eerdemgundogdu/avtech-agv-main/hardware/output/avtech-agv-carrier-revA-bom.csv

Adet | Referanslar | Deger | Footprint | Parca | Not
1 | BZ1 | 5V aktif | Buzzer_12x9.5RM7.6 | 12 mm 5V aktif buzzer
1 | C1 | 47uF 63V | CP_Elec_8x10 | Panasonic EEE-FK1J470P | Toplu giris kondansatoru
2 | C2 C3 | 2.2uF 100V | C_1210_3225Metric | X7R 1210 100V
1 | C4 | 100nF 25V | C_0603_1608Metric | X7R 0603 25V
2 | C5 C6 | 22uF 10V | C_1206_3216Metric | X7R 1206 10V
2 | C7 C8 | 1uF | C_0603_1608Metric | X7R 0603 16V
1 | C9 | 10uF | C_0805_2012Metric | X5R 0805 10V
2 | C10 C11 | 100nF | C_0603_1608Metric | X7R 0603 16V
3 | D1 D3 D10 | SS16 | D_SMA | SS16 (60V 1A) | Bobin serbest gecis diyodu; Buck serbest gecis (catch) diyodu; Ters kutup korumasi
1 | D2 | SMBJ30CA | D_SMB | Littelfuse SMBJ30CA | Vrwm 30V; motor kaynakli sicramalar
1 | D4 | B5819W | D_SOD-123 | B5819W (40V 1A) | USB 5V ile kart 5V birbirini beslemesin
1 | D5 | YESIL | LED_0603_1608Metric | 0603 yesil LED | +5V var
2 | D6 D7 | BAT54S | SOT-23 | BAT54S | RX kiskaci; TX kiskaci
1 | D8 | 1N4148W | D_SOD-323 | 1N4148WS | Buzzer serbest gecis
1 | D9 | MAVI | LED_0603_1608Metric | 0603 mavi LED | Durum (pin 2)
1 | D11 | KIRMIZI | LED_0603_1608Metric | 0603 kirmizi LED | Motor gucu acik
1 | D12 | BZT52C3V3 | D_SOD-123 | BZT52C3V3 | 3.3 V kiskac
1 | F1 | 1A 63V | Fuse_1206_3216Metric | Littelfuse 0466001.NRHF | Lojik + kontaktor bobini
1 | J1 | 24V AKU | TerminalBlock_Phoenix_MKDS-1,5-2-5.08_1x02_P5.08mm_Horizontal | Phoenix 1715721 | Aku girisi (sigortali hattan)
1 | J2 | HOVERBOARD | JST_XH_B3B-XH-A_1x03_P2.50mm_Vertical | JST B3B-XH-A | 15V pini bilerek yok
1 | J3 | IMU SPI | JST_XH_B6B-XH-A_1x06_P2.50mm_Vertical | JST B6B-XH-A
1 | J4 | QTR-8A | JST_XH_B11B-XH-A_1x11_P2.50mm_Vertical | JST B11B-XH-A | Pin 3 = LEDON (hep acik)
1 | J5 | HC-SR04 ON | JST_XH_B4B-XH-A_1x04_P2.50mm_Vertical | JST B4B-XH-A
1 | J6 | HC-SR04 SOL | JST_XH_B4B-XH-A_1x04_P2.50mm_Vertical | JST B4B-XH-A
1 | J7 | HC-SR04 SAG | JST_XH_B4B-XH-A_1x04_P2.50mm_Vertical | JST B4B-XH-A
1 | J8 | DM556 | JST_XH_B6B-XH-A_1x06_P2.50mm_Vertical | JST B6B-XH-A | PUL+ PUL- DIR+ DIR- ENA+ ENA-
1 | J9 | E-STOP (NC) | JST_XH_B2B-XH-A_1x02_P2.50mm_Vertical | JST B2B-XH-A | Normalde kapali buton
1 | J10 | KONTAKTOR | JST_XH_B2B-XH-A_1x02_P2.50mm_Vertical | JST B2B-XH-A | 24V bobin, <= 0.4 A
1 | L1 | 22uH | L_Bourns_SRN6045TA | Bourns SRN6045TA-220M | Isat >= 1 A gerekli
4 | Q1 Q2 Q3 Q4 | AO3400A | SOT-23 | AOS AO3400A
1 | Q5 | BCP56-16 | SOT-223-3_TabPin2 | Nexperia BCP56-16 | 80V 1A; hFE 100-250
5 | R1 R21 R22 R23 R25 | 100k | R_0603_1608Metric | 0603 100k 1%
1 | R2 | 54.9k | R_0603_1608Metric | 0603 54.9k 1%
4 | R3 R28 R29 R31 | 10k | R_0603_1608Metric | 0603 10k 1%
4 | R4 R12 R14 R16 | 2.2k | R_0603_1608Metric | 0603 2.2k 1%
3 | R5 R6 R32 | 1k | R_0603_1608Metric | 0603 1k 1%
2 | R7 R8 | 33 | R_0603_1608Metric | 0603 33 1%
7 | R9 R10 R11 R18 R19 R20 R24 | 100 | R_0603_1608Metric | 0603 100 1%
3 | R13 R15 R17 | 3.3k | R_0603_1608Metric | 0603 3.3k 1%
1 | R26 | 330 | R_0603_1608Metric | 0603 330 1%
1 | R27 | 470 | R_0603_1608Metric | 0603 470 1%
1 | R30 | 47k | R_0603_1608Metric | 0603 47k 1%
1 | U1 | LMR16006XDDCR | SOT-23-6 | TI LMR16006XDDCR | X versiyonu (700 kHz); sembol Y ile pin uyumlu
1 | U2 | AP2112K-3.3 | SOT-23-5 | Diodes AP2112K-3.3TRG1 | 600 mA; QTR-8A + IMU
1 | U3 | Teensy 4.1 | Teensy4.1_Socket | PJRC Teensy 4.1 + 2x 1x24 disi header | Tum 3.3V pinleri bos; VIN D4 uzerinden
