eerdemgundogdu/avtech-agv-main/hardware/output/avtech-agv-carrier-revA-schematic.pdf

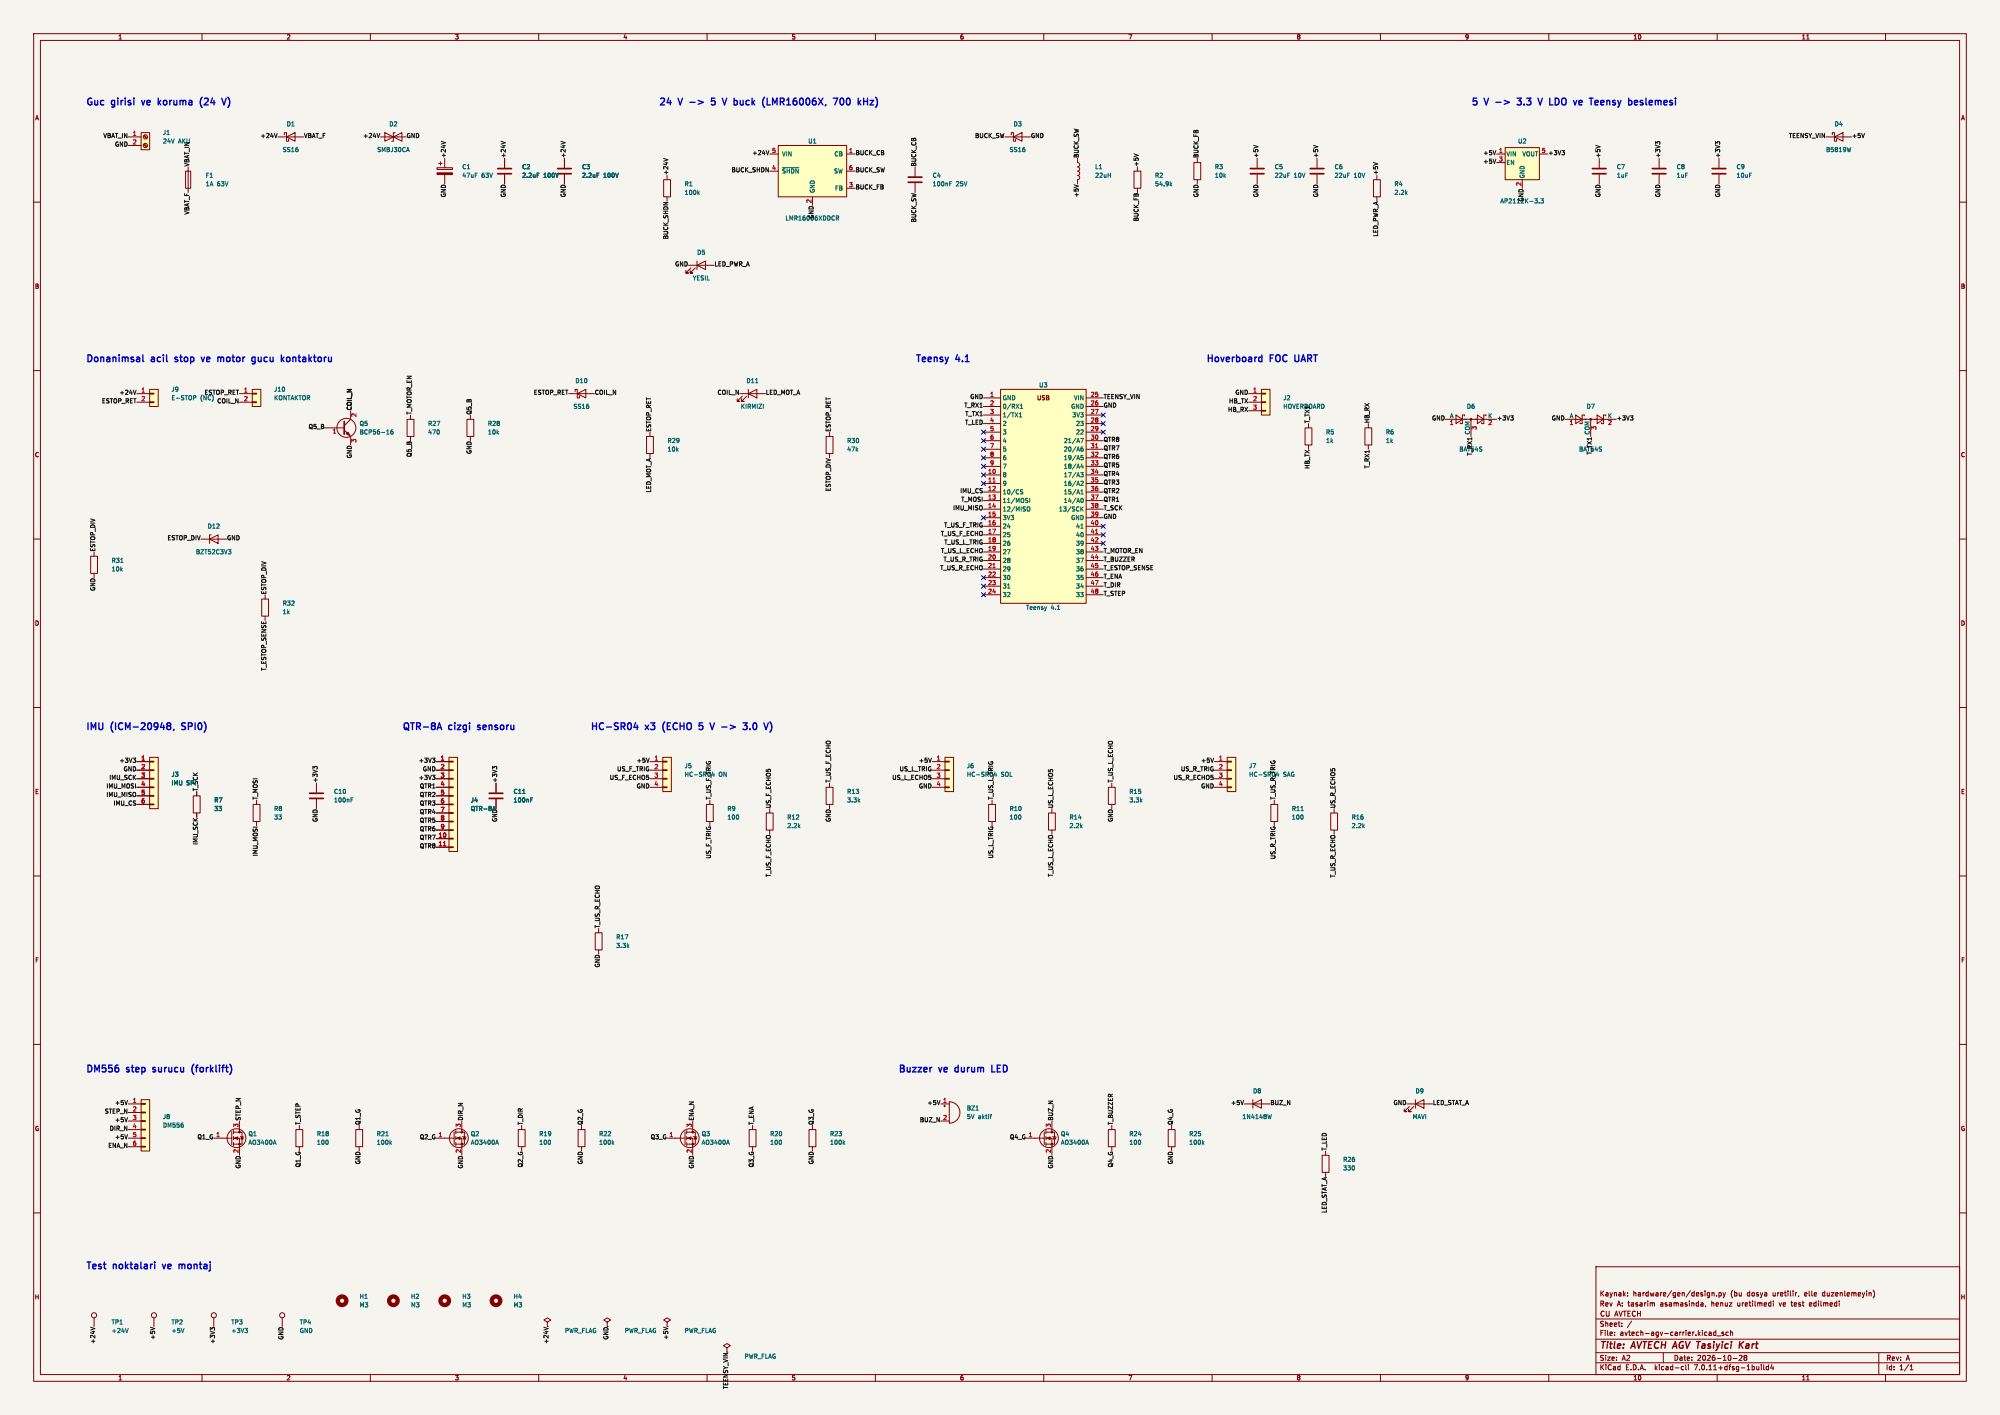
[picture p1: page 1]

Guc girisi ve koruma (24 V)

2 FB 3 ~{SHDN} 4 VIN 5 SW 6 U1

Donanimsal acil stop ve motor gucu kontaktoru

Test noktalari ve montaj
