eerdemgundogdu/avtech-agv-main/hardware/avtech-agv-carrier/avtech-agv-carrier.kicad_pcb

## KiCad design hardware/avtech-agv-carrier/avtech-agv-carrier.kicad_pcb (2026-10-28)

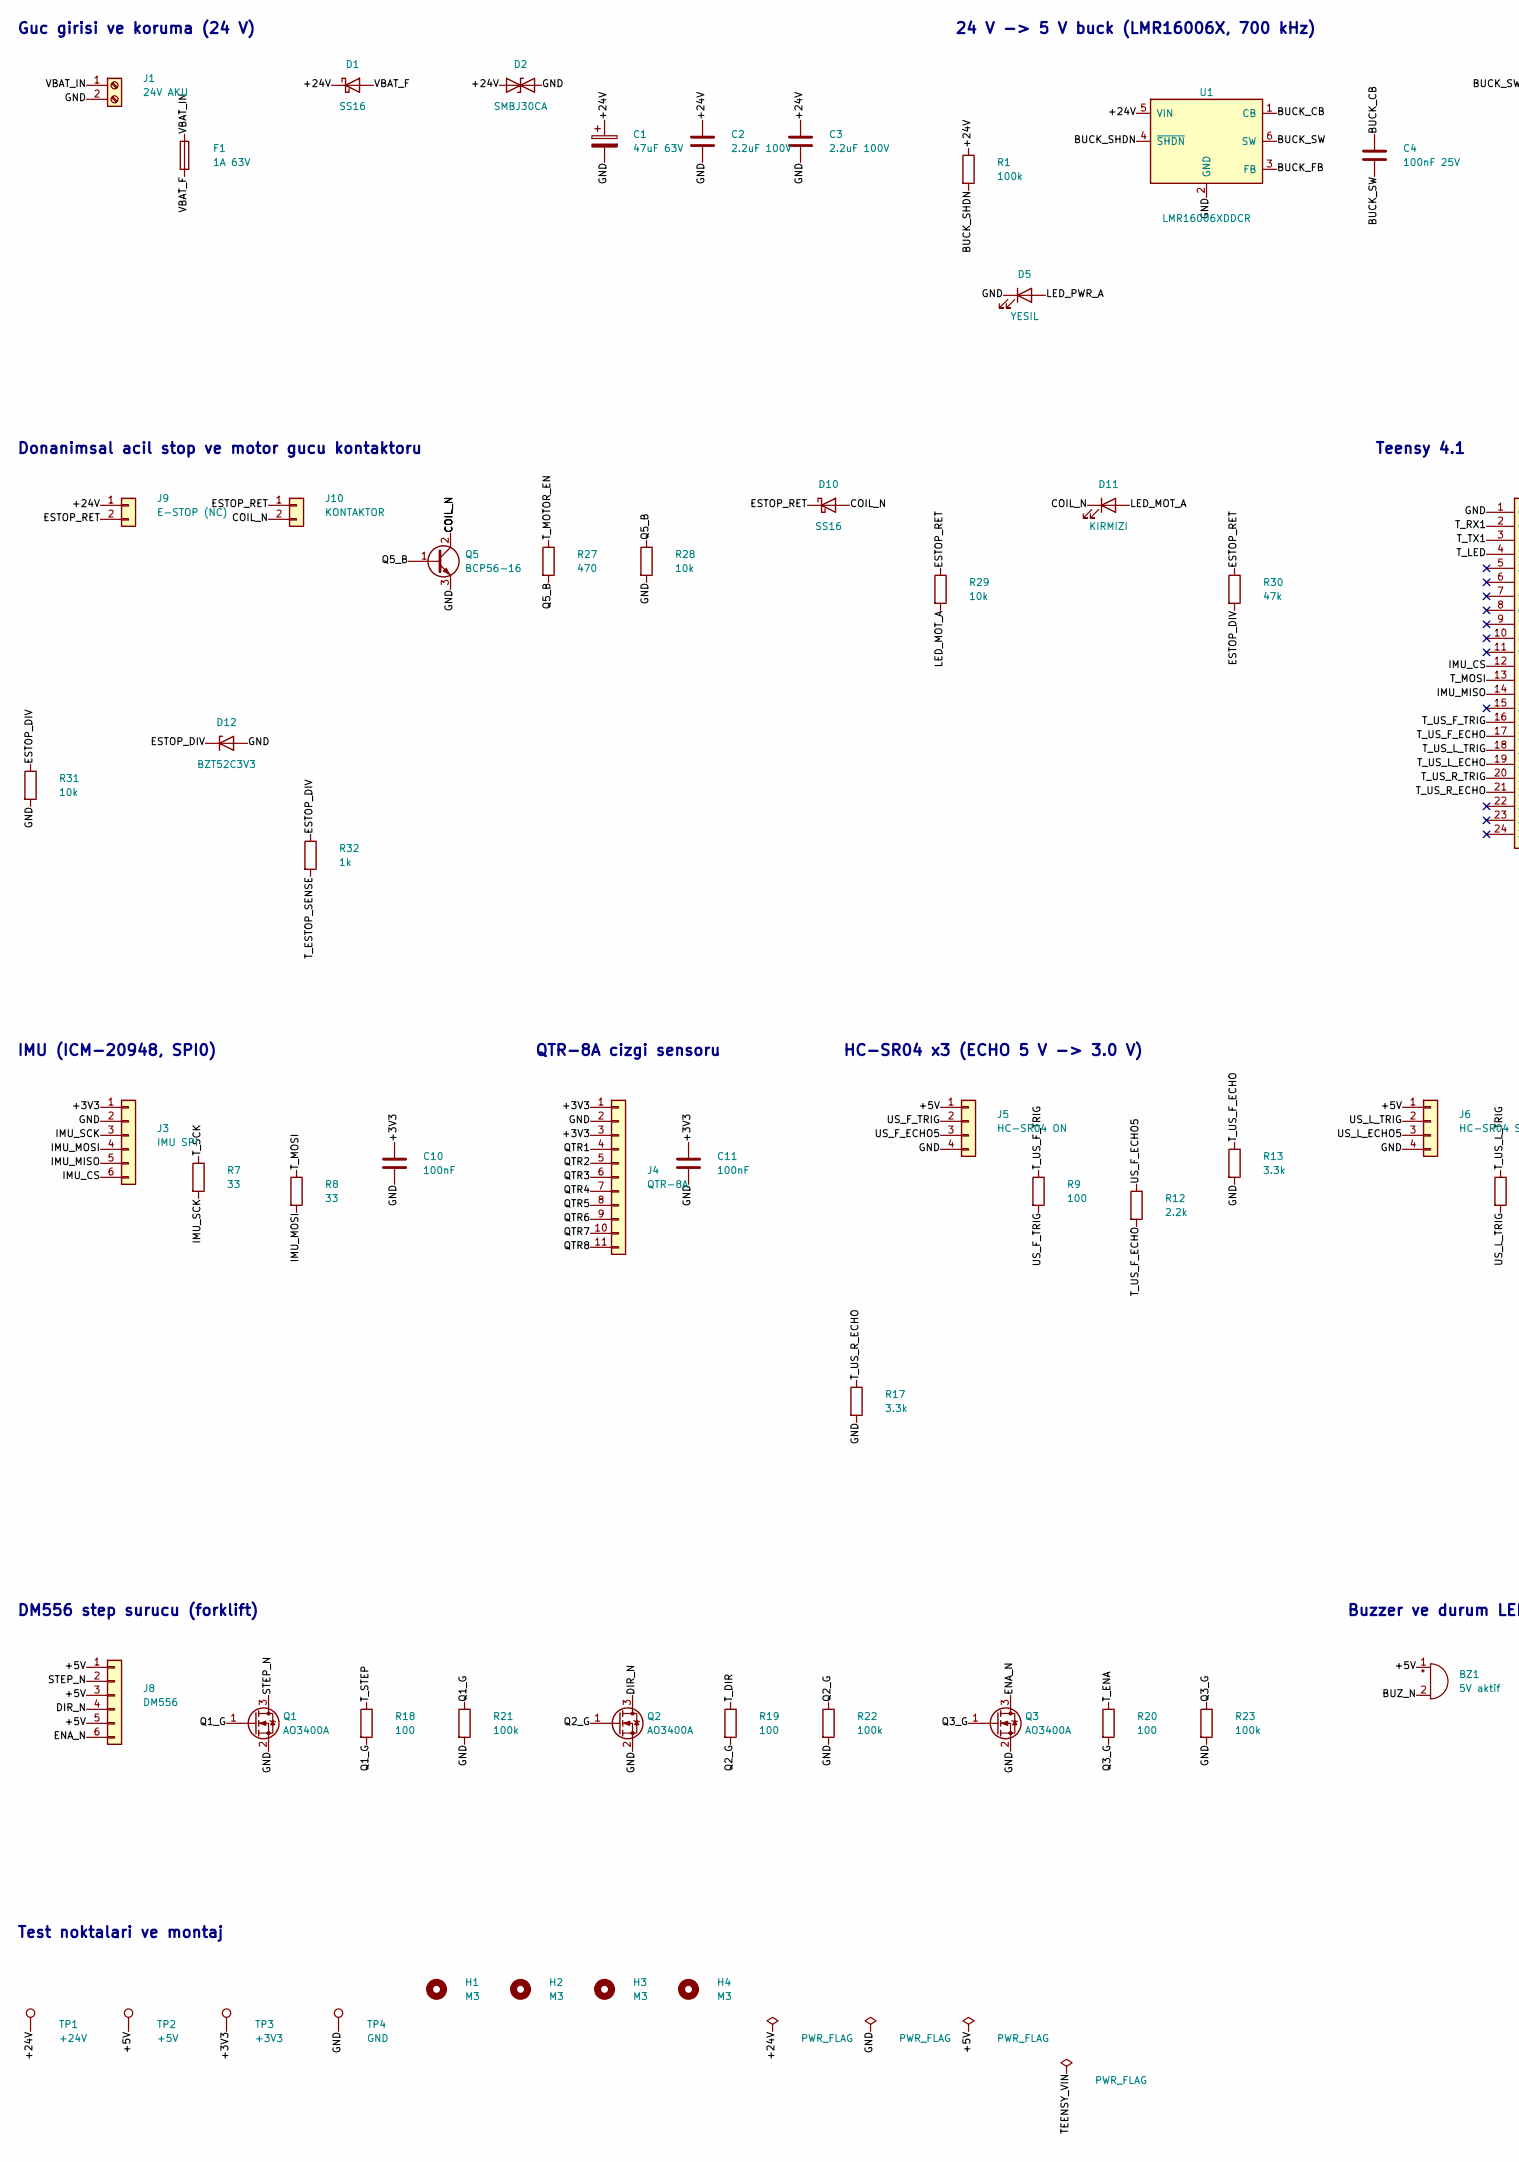
[picture p2: schematic avtech-agv-carrier.kicad_sch, AVTECH AGV Tasiyici Kart, part in row 1, column 1]

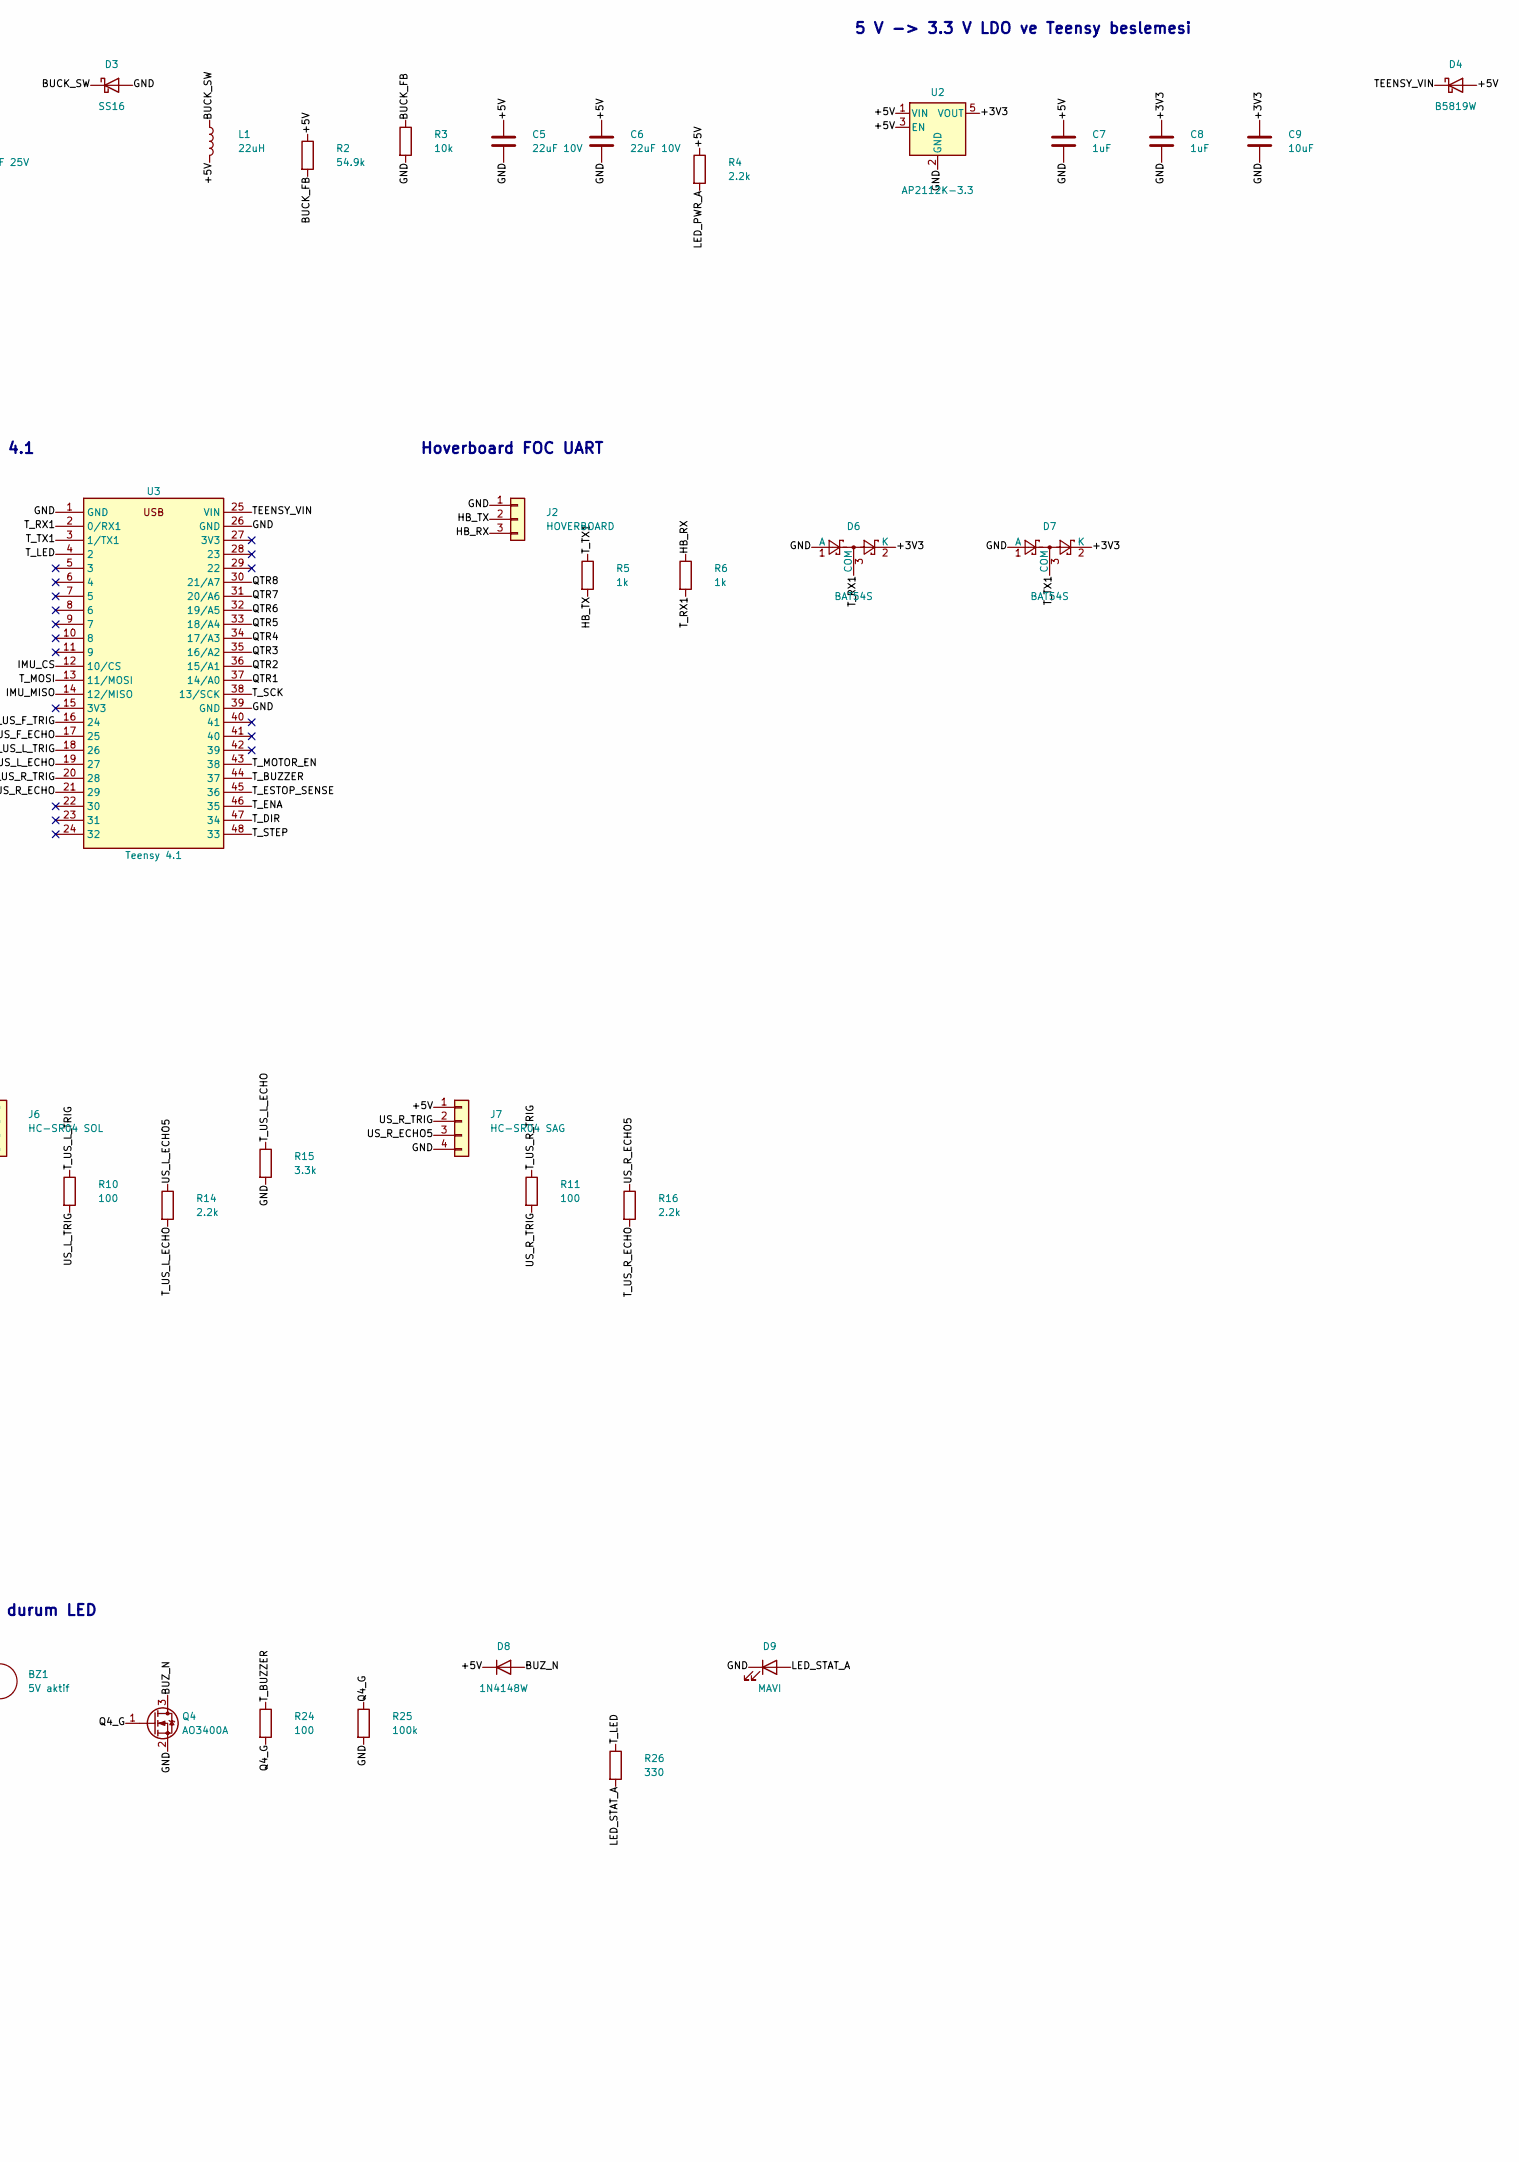
[picture p3: schematic avtech-agv-carrier.kicad_sch, AVTECH AGV Tasiyici Kart, part in row 1, column 2]

Parts:
BZ1: 5V aktif; Buzzer_12x9.5RM7.6; MPN 12 mm 5V aktif buzzer
C1: 47uF 63V; CP_Elec_8x10; MPN Panasonic EEE-FK1J470P
C2, C3: 2.2uF 100V; C_1210_3225Metric; MPN X7R 1210 100V
C4: 100nF 25V; C_0603_1608Metric; MPN X7R 0603 25V
C5, C6: 22uF 10V; C_1206_3216Metric; MPN X7R 1206 10V
C7, C8: 1uF; C_0603_1608Metric; MPN X7R 0603 16V
C9: 10uF; C_0805_2012Metric; MPN X5R 0805 10V
C10, C11: 100nF; C_0603_1608Metric; MPN X7R 0603 16V
D1, D3, D10: SS16; D_SMA; MPN SS16 (60V 1A)
D2: SMBJ30CA; D_SMB; MPN Littelfuse SMBJ30CA
D4: B5819W; D_SOD-123; MPN B5819W (40V 1A)
D5: YESIL; LED_0603_1608Metric; MPN 0603 yesil LED
D6, D7: BAT54S; SOT-23; MPN BAT54S
D8: 1N4148W; D_SOD-323; MPN 1N4148WS
D9: MAVI; LED_0603_1608Metric; MPN 0603 mavi LED
D11: KIRMIZI; LED_0603_1608Metric; MPN 0603 kirmizi LED
D12: BZT52C3V3; D_SOD-123; MPN BZT52C3V3
F1: 1A 63V; Fuse_1206_3216Metric; MPN Littelfuse 0466001.NRHF
H1, H2, H3, H4: M3; MountingHole_3.2mm_M3
J1: 24V AKU; TerminalBlock_Phoenix_MKDS-1,5-2-5.08_1x02_P5.08mm_Horizont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; MPN Phoenix 1715721
J2: HOVERBOARD; JST_XH_B3B-XH-A_1x03_P2.50mm_Vertical; MPN JST B3B-XH-A
J3: IMU SPI; JST_XH_B6B-XH-A_1x06_P2.50mm_Vertical; MPN JST B6B-XH-A
J4: QTR-8A; JST_XH_B11B-XH-A_1x11_P2.50mm_Vertical; MPN JST B11B-XH-A
J5: HC-SR04 ON; JST_XH_B4B-XH-A_1x04_P2.50mm_Vertical; MPN JST B4B-XH-A
J6: HC-SR04 SOL; JST_XH_B4B-XH-A_1x04_P2.50mm_Vertical; MPN JST B4B-XH-A
J7: HC-SR04 SAG; JST_XH_B4B-XH-A_1x04_P2.50mm_Vertical; MPN JST B4B-XH-A
J8: DM556; JST_XH_B6B-XH-A_1x06_P2.50mm_Vertical; MPN JST B6B-XH-A
J9: E-STOP (NC); JST_XH_B2B-XH-A_1x02_P2.50mm_Vertical; MPN JST B2B-XH-A
J10: KONTAKTOR; JST_XH_B2B-XH-A_1x02_P2.50mm_Vertical; MPN JST B2B-XH-A
L1: 22uH; L_Bourns_SRN6045TA; MPN Bourns SRN6045TA-220M
Q1, Q2, Q3, Q4: AO3400A; SOT-23; MPN AOS AO3400A
Q5: BCP56-16; SOT-223-3_TabPin2; MPN Nexperia BCP56-16
R1, R21, R22, R23, R25: 100k; R_0603_1608Metric; MPN 0603 100k 1%
R2: 54.9k; R_0603_1608Metric; MPN 0603 54.9k 1%
R3, R28, R29, R31: 10k; R_0603_1608Metric; MPN 0603 10k 1%
R4, R12, R14, R16: 2.2k; R_0603_1608Metric; MPN 0603 2.2k 1%
R5, R6, R32: 1k; R_0603_1608Metric; MPN 0603 1k 1%
R7, R8: 33; R_0603_1608Metric; MPN 0603 33 1%
R9, R10, R11, R18, R19, R20, R24: 100; R_0603_1608Metric; MPN 0603 100 1%
R13, R15, R17: 3.3k; R_0603_1608Metric; MPN 0603 3.3k 1%
R26: 330; R_0603_1608Metric; MPN 0603 330 1%
R27: 470; R_0603_1608Metric; MPN 0603 470 1%
R30: 47k; R_0603_1608Metric; MPN 0603 47k 1%
TP1: +24V; TestPoint_Pad_D1.5mm
TP2: +5V; TestPoint_Pad_D1.5mm
TP3: +3V3; TestPoint_Pad_D1.5mm
TP4: GND; TestPoint_Pad_D1.5mm
U1: LMR16006XDDCR; SOT-23-6; MPN TI LMR16006XDDCR
U2: AP2112K-3.3; SOT-23-5; MPN Diodes AP2112K-3.3TRG1
U3: Teensy 4.1; Teensy4.1_Socket; MPN PJRC Teensy 4.1 + 2x 1x24 disi header

Connections:
+3V3: C8.1, C9.1, C10.1, C11.1, D6.2 (K), D7.2 (K), J3.1, J4.1, J4.3, TP3.1, U2.5 (VOUT)
+5V: BZ1.1 (+), C5.1, C6.1, C7.1, D4.2 (A), D8.1 (K), J5.1, J6.1, J7.1, J8.1, J8.3, J8.5, L1.2, R2.1, R4.1, TP2.1, U2.1 (VIN), U2.3 (EN)
+24V: C1.1, C2.1, C3.1, D1.1 (K), D2.1 (A1), J9.1, R1.1, TP1.1, U1.5 (VIN)
BUCK_CB: C4.1, U1.1 (CB)
BUCK_FB: R2.2, R3.1, U1.3 (FB)
BUCK_SHDN: R1.2, U1.4 (~SHDN)
BUCK_SW: C4.2, D3.1 (K), L1.1, U1.6 (SW)
BUZ_N: BZ1.2 (-), D8.2 (A), Q4.3 (D)
COIL_N: D10.2 (A), D11.1 (K), J10.2, Q5.2 (C), Q5.4 (C)
DIR_N: J8.4, Q2.3 (D)
ENA_N: J8.6, Q3.3 (D)
ESTOP_DIV: D12.1 (K), R30.2, R31.1, R32.1
ESTOP_RET: D10.1 (K), J9.2, J10.1, R29.1, R30.1
GND: C1.2, C2.2, C3.2, C5.2, C6.2, C7.2, C8.2, C9.2, C10.2, C11.2, D2.2 (A2), D3.2 (A), D5.1 (K), D6.1 (A), D7.1 (A), D9.1 (K), D12.2 (A), J1.2, J2.1, J3.2, J4.2, J5.4, J6.4, J7.4, Q1.2 (S), Q2.2 (S), Q3.2 (S), Q4.2 (S), Q5.3 (E), R3.2, R13.2, R15.2, R17.2, R21.2, R22.2, R23.2, R25.2, R28.2, R31.2, TP4.1, U1.2 (GND), U2.2 (GND), U3.1 (GND), U3.26 (GND), U3.39 (GND)
HB_RX: J2.3, R6.1
HB_TX: J2.2, R5.2
IMU_CS: J3.6, U3.12 (10/CS)
IMU_MISO: J3.5, U3.14 (12/MISO)
IMU_MOSI: J3.4, R8.2
IMU_SCK: J3.3, R7.2
LED_MOT_A: D11.2 (A), R29.2
LED_PWR_A: D5.2 (A), R4.2
LED_STAT_A: D9.2 (A), R26.2
Q1_G: Q1.1 (G), R18.2, R21.1
Q2_G: Q2.1 (G), R19.2, R22.1
Q3_G: Q3.1 (G), R20.2, R23.1
Q4_G: Q4.1 (G), R24.2, R25.1
Q5_B: Q5.1 (B), R27.2, R28.1
QTR1: J4.4, U3.37 (14/A0)
QTR2: J4.5, U3.36 (15/A1)
QTR3: J4.6, U3.35 (16/A2)
QTR4: J4.7, U3.34 (17/A3)
QTR5: J4.8, U3.33 (18/A4)
QTR6: J4.9, U3.32 (19/A5)
QTR7: J4.10, U3.31 (20/A6)
QTR8: J4.11, U3.30 (21/A7)
STEP_N: J8.2, Q1.3 (D)
TEENSY_VIN: D4.1 (K), U3.25 (VIN)
T_BUZZER: R24.1, U3.44 (37)
T_DIR: R19.1, U3.47 (34)
T_ENA: R20.1, U3.46 (35)
T_ESTOP_SENSE: R32.2, U3.45 (36)
T_LED: R26.1, U3.4 (2)
T_MOSI: R8.1, U3.13 (11/MOSI)
T_MOTOR_EN: R27.1, U3.43 (38)
T_RX1: D6.3 (COM), R6.2, U3.2 (0/RX1)
T_SCK: R7.1, U3.38 (13/SCK)
T_STEP: R18.1, U3.48 (33)
T_TX1: D7.3 (COM), R5.1, U3.3 (1/TX1)
T_US_F_ECHO: R12.2, R13.1, U3.17 (25)
T_US_F_TRIG: R9.1, U3.16 (24)
T_US_L_ECHO: R14.2, R15.1, U3.19 (27)
T_US_L_TRIG: R10.1, U3.18 (26)
T_US_R_ECHO: R16.2, R17.1, U3.21 (29)
T_US_R_TRIG: R11.1, U3.20 (28)
US_F_ECHO5: J5.3, R12.1
US_F_TRIG: J5.2, R9.2
US_L_ECHO5: J6.3, R14.1
US_L_TRIG: J6.2, R10.2
US_R_ECHO5: J7.3, R16.1
US_R_TRIG: J7.2, R11.2
VBAT_F: D1.2 (A), F1.2
VBAT_IN: F1.1, J1.1

Notes on the sheet:
Guc girisi ve koruma (24 V)
24 V -> 5 V buck (LMR16006X, 700 kHz)
5 V -> 3.3 V LDO ve Teensy beslemesi
Donanimsal acil stop ve motor gucu kontaktoru
Teensy 4.1
Hoverboard FOC UART
IMU (ICM-20948, SPI0)
QTR-8A cizgi sensoru
HC-SR04 x3 (ECHO 5 V -> 3.0 V)
DM556 step surucu (forklift)
Buzzer ve durum LED
Test noktalari ve montaj

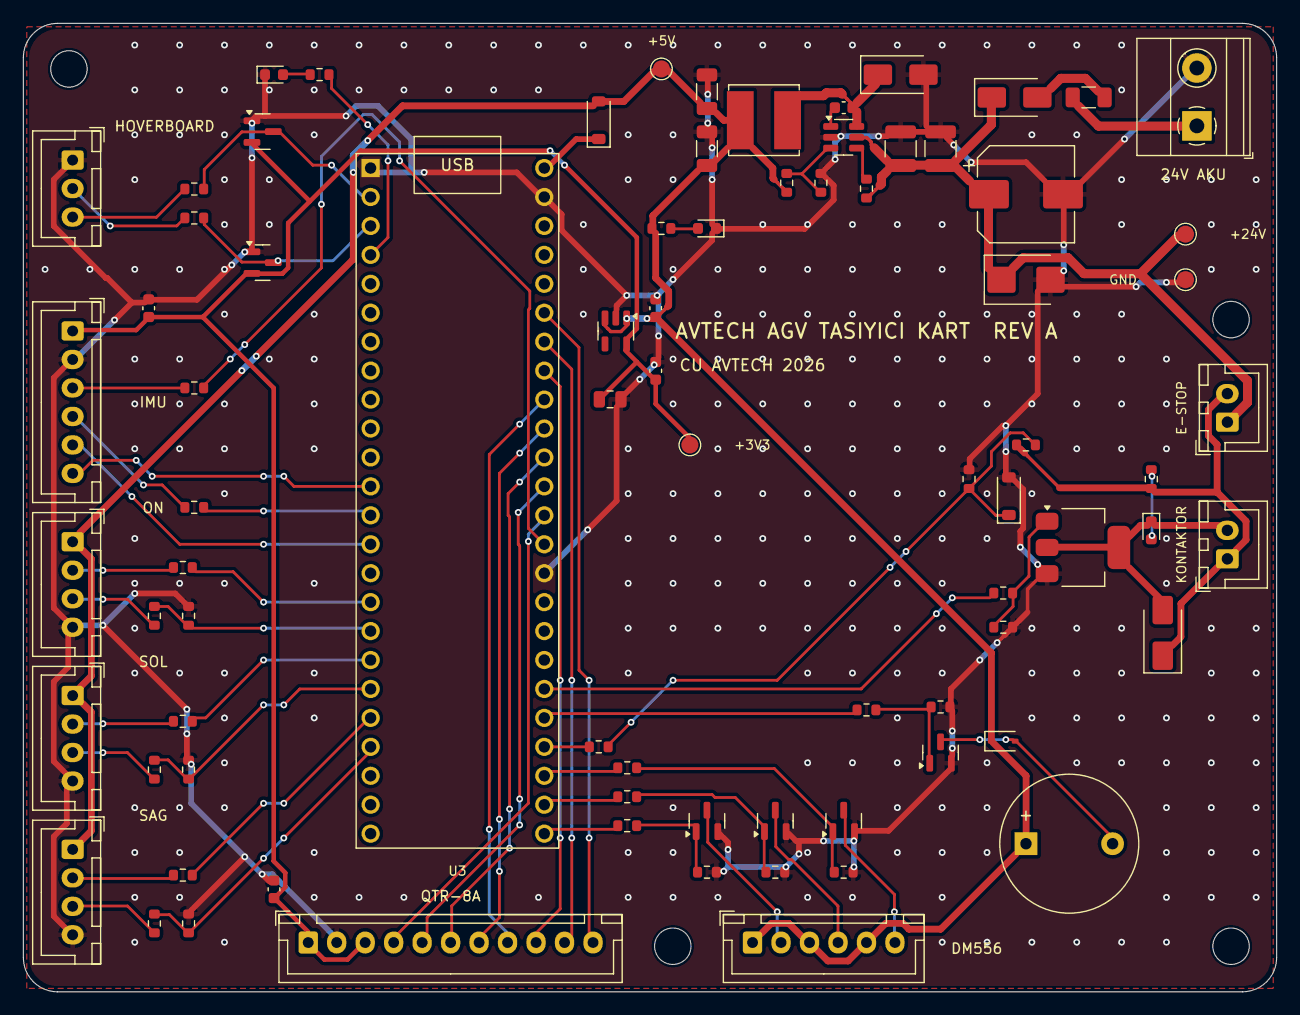
[picture p4: board avtech-agv-carrier.kicad_pcb from above]

Board: 2 copper layers, 110.0 x 85.0 mm, 84 parts (0 on the bottom side), 63 nets.
