eerdemgundogdu/avtech-agv-main/(commit log)

2026-10-22 Add EKF localization with gyro bias estimation and QR landmark updates
2026-10-28 Extract host-testable firmware modules, add firmware CI and EKF figure
    Firmware:
    - cmd_parser.cpp: the allocation-free JSON command reader and line
    assembler, moved out of the sketch with no Arduino dependency.
    - hover_protocol.cpp: EFeru FOC framing, word XOR checksum and speed ramp.
    Feedback is decoded with explicit little-endian reads instead of casting
    a struct over an unaligned byte buffer.
    - Hoverboard feedback parser now resyncs on the next 0xCD 0xAB inside a
    rejected frame instead of discarding it, so a real frame that starts
    inside a false start caused by line noise is not lost.
    Tests and CI:
    - firmware_tests/: 18 host tests built with -Werror and ASan/UBSan.
    - platformio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
    [cmd_parser.cpp, cmd_parser.h, ekf_test.py, hover_protocol.cpp, hover_protocol.h, hoverboard_driver.cpp, hoverboard_driver.h]
2026-10-28 Add Rev A carrier board (KiCad) with hardware E-stop and motor enable
    - hardware/: 24 V input carrier for Teensy 4.1 (TVS, reverse-polarity,
    LMR16006X 5 V buck, AP2112K 3.3 V LDO), sensor/encoder connectors with
    level shifting, hardware E-stop loop that drops the contactor, motor
    enable line on pin 38
    - Schematic and PCB generated from one netlist (hardware/gen), parity check,
    2-layer routing, GND pours with stitching vias; local DRC 0/0
    - Gerbers, drill, pick-and-place, BOM and schematic PDF in hardware/output
    - DESIGN.md (calculations, review checklist), WIRING.md
    - Firmware: CARRIER_BOARD_REV flag, teensy41_carrier PlatformIO env,
    MOTOR_EN gated by nav fault / Jetson link / E-st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
    [avtech-agv-carrier-revA-bom.csv, avtech-agv-carrier.kicad_pcb, avtech-agv-carrier.kicad_sch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]
2026-10-28 ci(hardware): run KiCad container as root so checkout can write the workspace
2026-10-28 ci(hardware): drop --refill-zones (not in KiCad 9.0 CLI); zones are filled in the file
2026-10-28 hardware: solid zone connection on Teensy GND pins (fixes KiCad 9 starved_thermal)
    [avtech-agv-carrier.kicad_pcb]
